celentanos/mca/docs/batteryuniversity links.txt

http://batteryuniversity.com/learn/article/charging_lithium_ion_batteries
http://batteryuniversity.com/learn/article/elevating_self_discharge
http://batteryuniversity.com/learn/article/what_everyone_should_know_about_battery_chargers
