celentanos/mca/Vortrag.odp

## Projekt zum Fach “Mikrocontroller-Anwendungen”

Akku-Aufbewhrungsstation

von

Andrej Lisnitzki und Martin Morcinietz

## Gliederung des Vortrags

1. Hintergrund einer Aufbewahrungsstation für Akkus
2. Vorüberlegungen
3. Verwendete Hardware
4. Umsetzung

## Hintergrund einer Aufbewahrungsstation für Akkus

- Vermeidung von Tiefentladung durch Überwachung des Akkus
- Kontrolliertes Aufladen des Akkus bis zu einer einstellbaren Kapazität
- Möglichkeit einer Voreinstellung des Datums zu welchem der Akku geladen werden soll

## Vorüberlegungen

- Wahl eines geeigneten Mikrocontrollers
- Entwurf einer geeigneten Ladeschaltung
- Darstellung / Visualisierung der Ausgaben
- Verwendung eines RTC
- Benutzereingaben durch Taster
- Software muss verschiedene Zustände realisieren

## Verwendete Hardware

- Arduino Nano Entwicklungsplatine mit ATmel 328 Mikrocontroller
- 16x2 LCD-Anzeige mit I²C-parallel-Umsetzer
- Digitaler Temperatursensor DS18B20
- Spannungsregler LM317
- RTC DS3231

## Umsetzung

- Einstellung des Datums und der Kapazität
- Aufbewahrungsfunktion
- Zwei Ladestrategien 20mA / 100mA
- Temperaturberwachung des Akkus

## Umsetzung

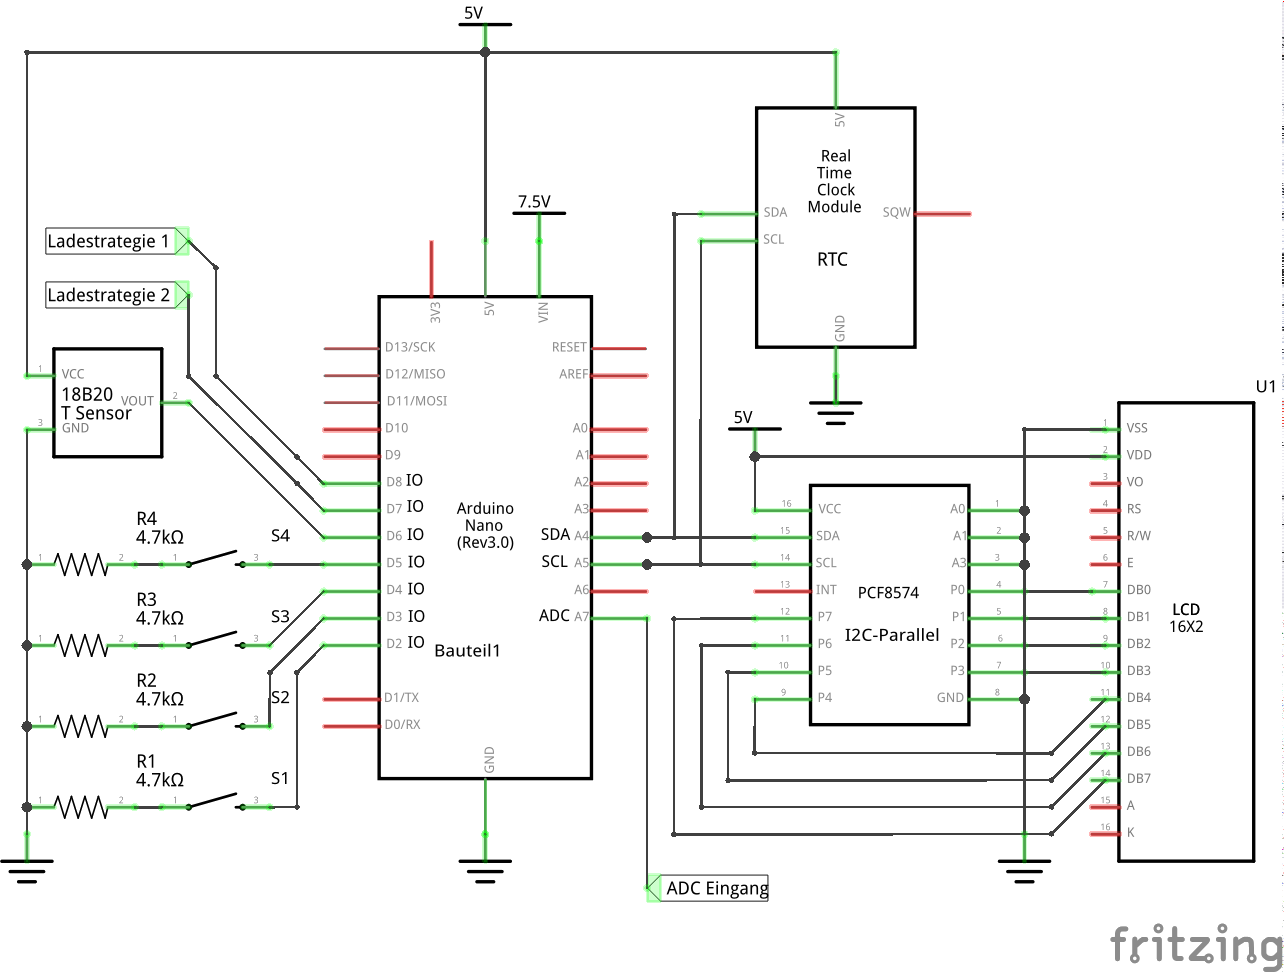
[picture p1: figure]

## Umsetzung

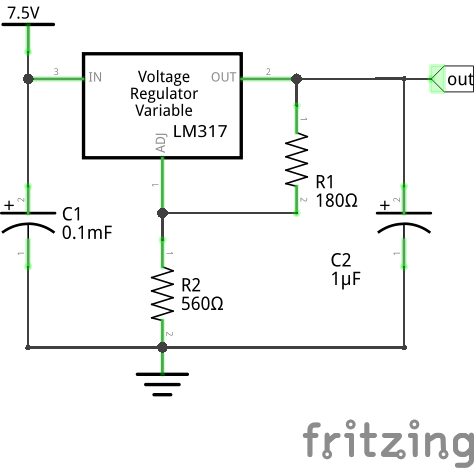
[picture p2: figure]

Spannungsregler

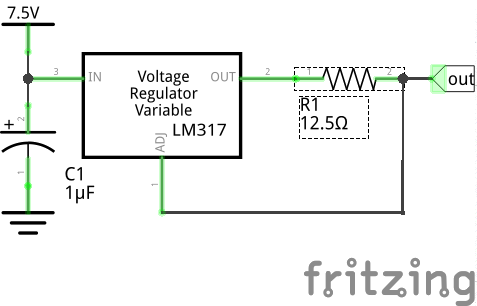
[picture p3: figure]

Stromregler

## Umsetzung

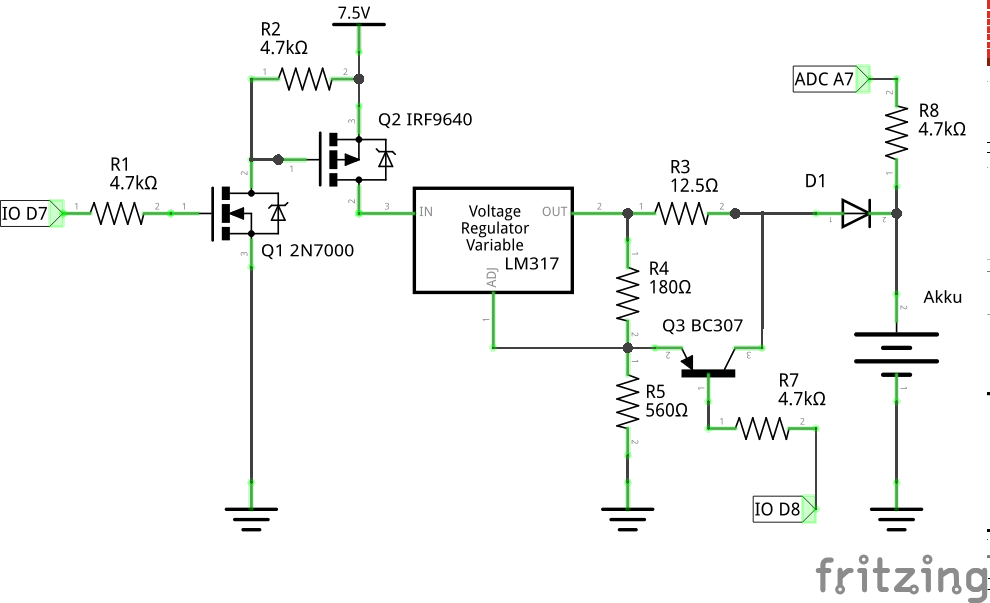
[picture p4: figure]

  Vielen Dank für Ihre Aufmerksamkeit
