celentanos/mca/docs/Mikrocontroller Anwendung.odt

Ladegerät für Li-Ion Akkus

Ziele:

1. Stufe: Laderegler

- Laden
  - schnelles Laden: 1C
    - Temperaturüberwachung
    - Klemmspannungüberwachung
    - Strommstärkeüberwachung
    - einstellbares Ladestrom
  - Einstellen der Lademodi ( langsam, schnell )
- Anzeige ( 1- o. 2-zeilige Anzeige ):
  - Klemmspannung
  - Stromstärke
  - Ladezustand ( defekt, leer, voll )
- Kommunikation mit dem PC ( FTDI )
  - mögliche Steuerung
  - Anzeige der Statusinformation
- Temperaturmanagementsystem ( je heißer desto langsamer )
- partielles Laden ( bis 50-70% und dann der Rest )
- Laden von tiefentladenen Akkus

2. Stufe: SRAM (EEPROM) über eine geeignete (SPI)-Schnittstelle zum Speichern von Lod-Daten einzubinden.

Akku-Lader-Lager

- Die Akkus sollen bis zu 50%, 70% geladen werden und zyklisch überwacht ob die gegebene Kapazität (Klemmspannung) noch vorhanden ist.
- Durch den User wird die Voll-Ladung zum Ladezeitpunkt (Datum wird eingestellt) eingeleitet.
- Ladestrom: 0,5C

Was wird benötigt:

- Arduino Nano
- Akkus
- FTDI
