celentanos/mca/alles was zum Dokument gehoert/Kommunikation one Wire.png

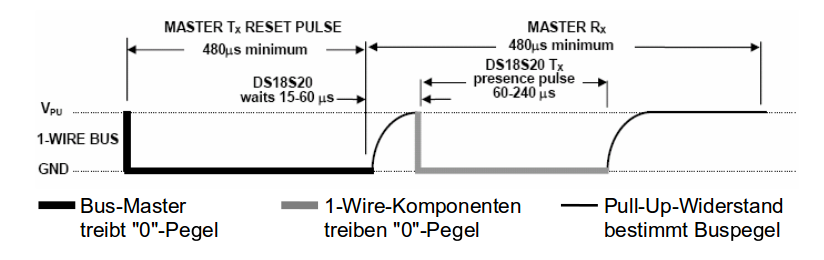
alles was zum Dokument gehoert/Kommunikation one Wire.png
