celentanos/mca/docs/TODO.txt

- Es soll zwischen Strom- und Spannungsquelle geschaltet werden, um die Akku bis zu gewiessen Weise zu sätigen.
