celentanos/mca/(list of files, drawings)

Other design files:
alles was zum Dokument gehoert/charge1_01.fzz
alles was zum Dokument gehoert/charge2_01.fzz
alles was zum Dokument gehoert/ladeschaltung_01.fzz
alles was zum Dokument gehoert/ladeschaltung_02.fzz
alles was zum Dokument gehoert/schaltplan_01.fzz
