celentanos/mca/(commit log)

2015-12-21 add some files
    [Li-Ion Spannungen.ods, MC.ods, µCs.ods]
2016-03-01 Sschaltung gemacht
    [ladeschaltung_01.fzz, ladeschaltung_02.fzz]
2016-03-08 TODO: richtige firmware
    [ladeschaltung_01.fzz, ladeschaltung_02.fzz]
2016-03-11 Einiges geändert, und Backup angelegt
2016-03-16 soll alles fertg sein, muss aber noch mit der richtigen platine getestet werden
    [Li-Ion Spannungen.ods]
2016-03-18 Dokument vervollständigt und formatiert. Ordner mit Bildern zum Dokument hinzugefügt...
2016-03-20 Erkennung: defekt und nicht eingesetzt hinzugefügt. double-Funktionen umgeschrieben
    [Li-Ion Spannungen.ods]
2016-03-21 TODO: der Text soll noch formatiert werden...
2016-03-21 Schaltplan verschoben
    [ladeschaltung_01.fzz, ladeschaltung_02.fzz]
2016-03-22 Doku vervollständigt. New pics...
    [charge1_01.fzz, charge2_01.fzz, ladeschaltung_02.fzz, schaltplan_01.fzz]
